pacoesteban/CC_Dummy_Load/panell_frontal.dxf

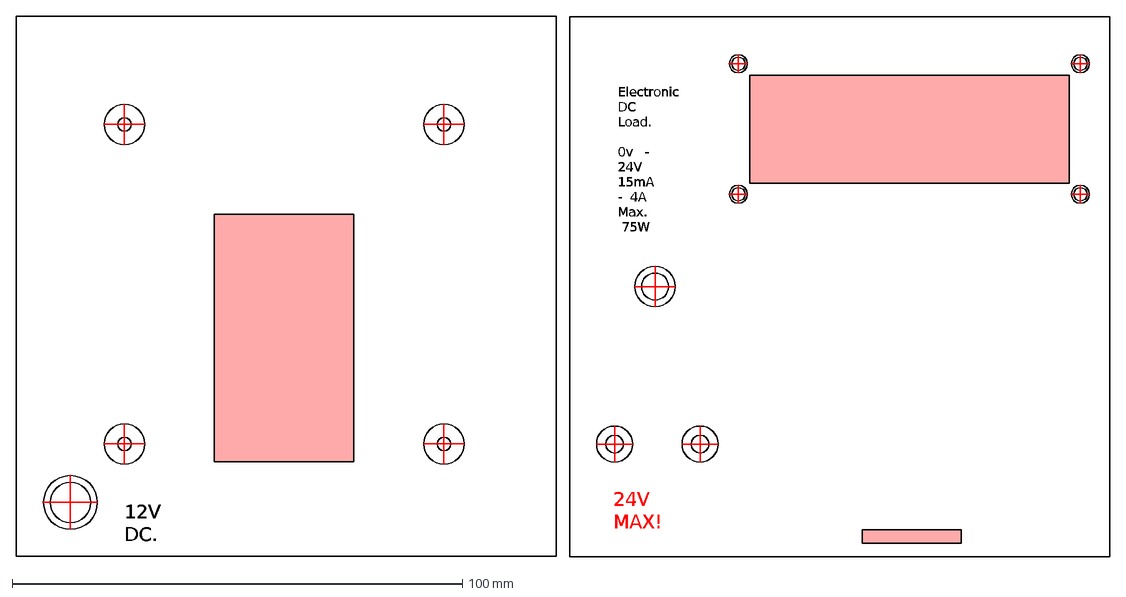
[picture p1: CAD file, 2016-04-08]
panell_frontal.dxf
12V DC.
Electronic DC Load. 0v - 24V 15mA - 4A Max. 75W
24V MAX!
