pacoesteban/CC_Dummy_Load/CC_dummy_load.kicad_pcb

## KiCad design CC_dummy_load.kicad_pcb (2016-03-09)

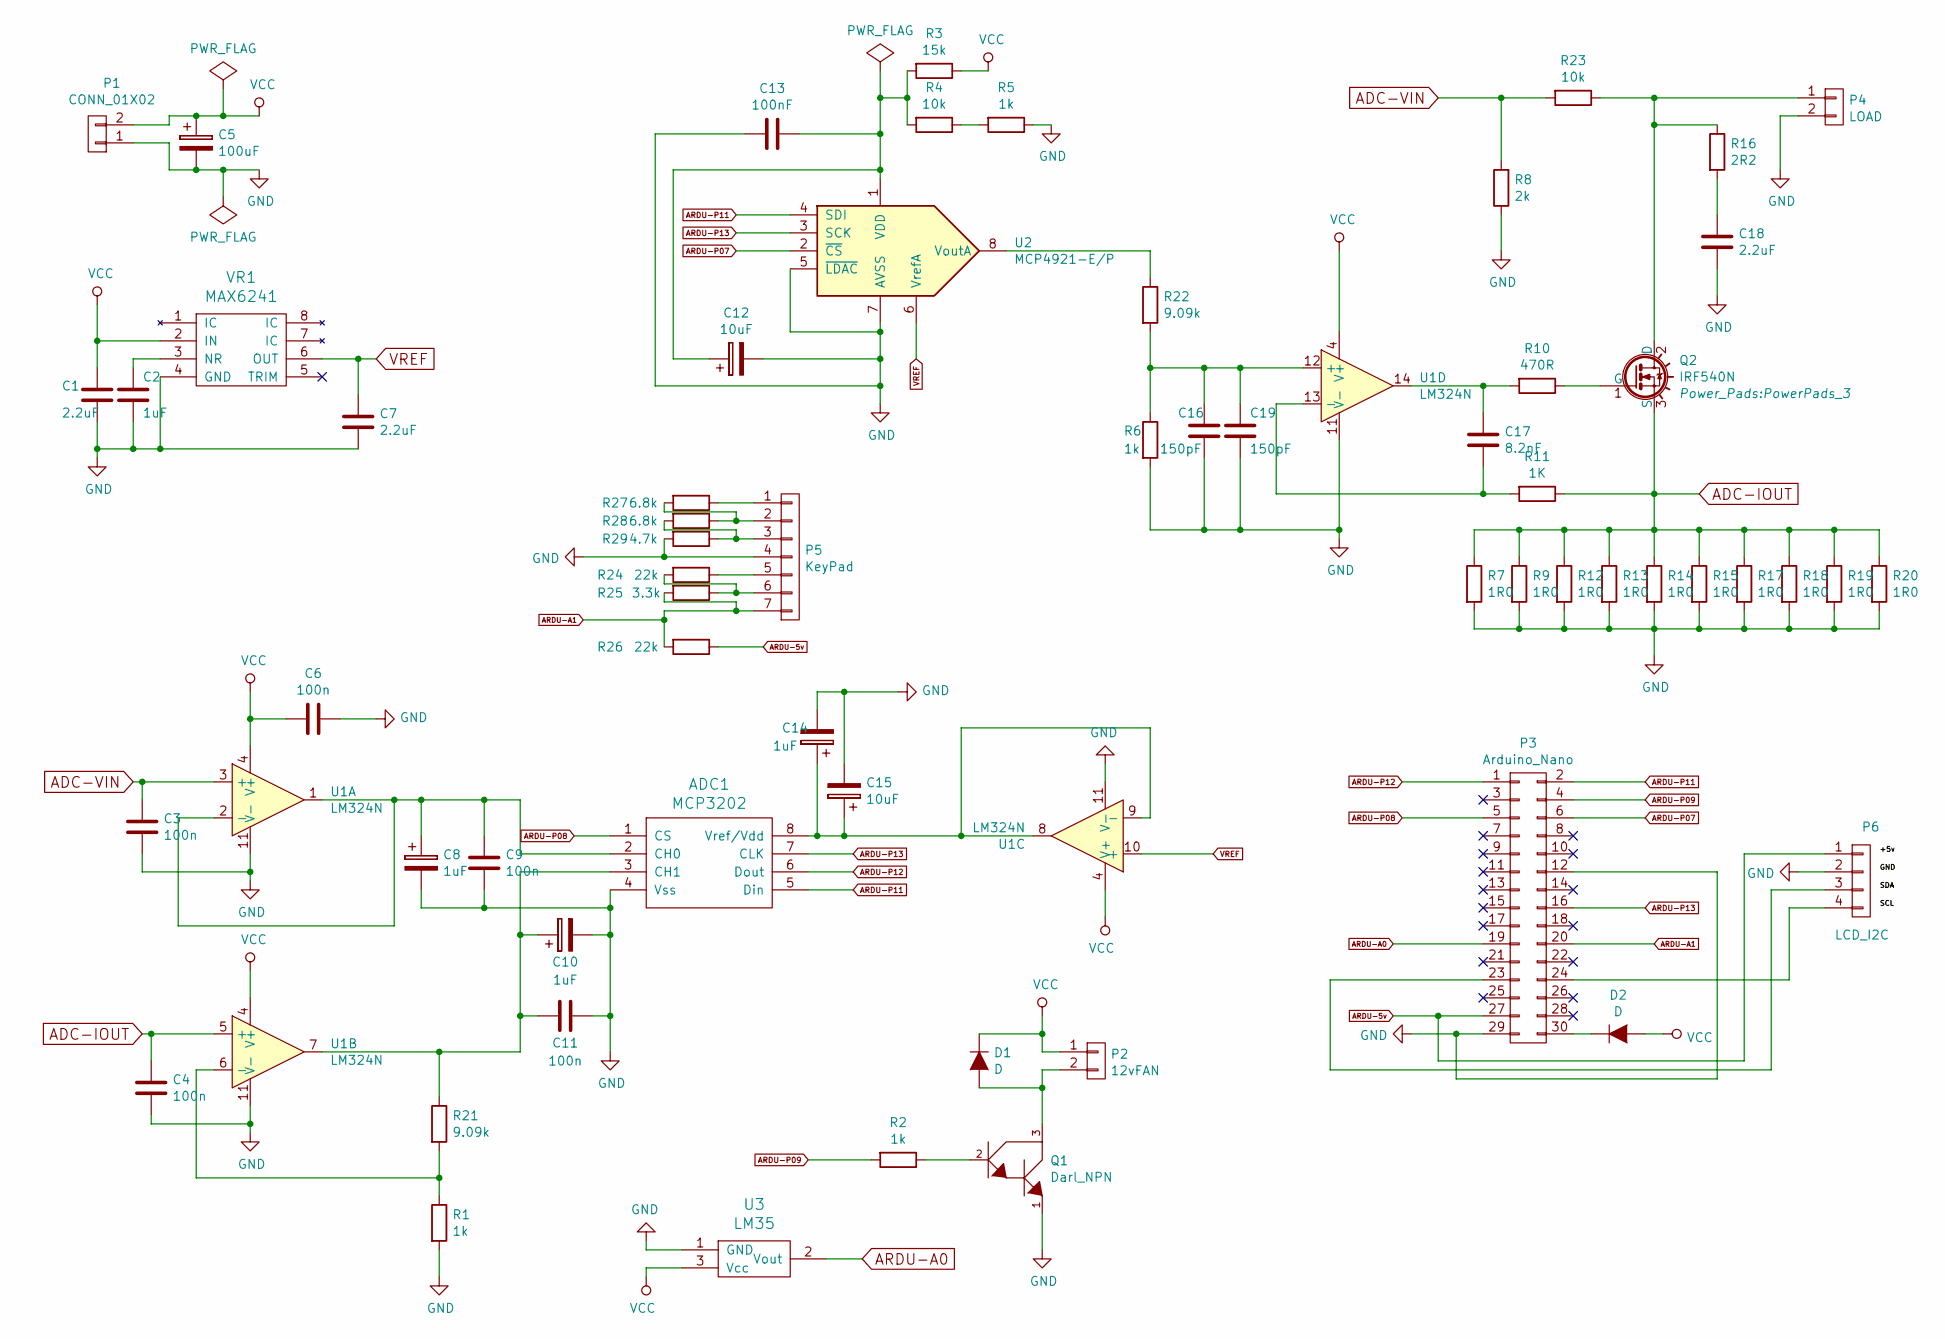
[picture p2: schematic CC_dummy_load.sch, Fucking DC Dummy Load]

Parts:
ADC1: MCP3202; DIP-8_W7.62mm
C1, C7, C18: 2.2uF; C_Disc_D6_P5
C2, C8, C10, C14: 1uF; C_Radial_D5_L11_P2
C3, C4, C6: 100n; C_Disc_D3_P2.5
C5: 100uF; C_Radial_D5_L11_P2.5
C9, C11: 100n; C_Disc_D6_P5
C12, C15: 10uF; C_Radial_D5_L11_P2
C13: 100nF; C_Disc_D6_P5
C16, C19: 150pF; C_Disc_D3_P2.5
C17: 8.2nF; C_Radial_D5_L11_P2
D1, D2: D; Diode_DO-41_SOD81_Horizontal_RM10
P1: CONN_01X02; bornier2
P2: 12vFAN; Pin_Header_Straight_1x02
P3: Arduino_Nano; Nano
P4: LOAD; bornier2
P5: KeyPad; Pin_Header_Straight_1x07
P6: LCD_I2C; Pin_Header_Straight_1x04
Q1: Darl_NPN; TO-92_Inline_Wide
Q2: IRF540N; PowerPads_3
R1, R2, R5, R6: 1k; Resistor_Horizontal_RM10mm
R3: 15k; Resistor_Horizontal_RM10mm
R4, R23: 10k; Resistor_Horizontal_RM10mm
R7, R9, R12, R13, R14, R15, R17, R18, R19, R20: 1R0; Resistor_Horizontal_RM10mm
R8: 2k; Resistor_Horizontal_RM10mm
R10: 470R; Resistor_Horizontal_RM10mm
R11: 1K; Resistor_Horizontal_RM10mm
R16: 2R2; Resistor_Horizontal_RM10mm
R21, R22: 9.09k; Resistor_Horizontal_RM10mm
R24, R26: 22k; Resistor_Horizontal_RM10mm
R25: 3.3k; Resistor_Horizontal_RM10mm
R27, R28: 6.8k; Resistor_Horizontal_RM10mm
R29: 4.7k; Resistor_Horizontal_RM10mm
U1: LM324N; DIP-14_W7.62mm
U2: MCP4921-E/P; DIP-8_W7.62mm
U3: LM35; Pin_Header_Straight_1x03
VR1: MAX6241; DIP-8_W7.62mm

Connections:
ADC-IOUT: C4.1, Q2.3 (S), R7.1, R9.1, R11.1, R12.1, R13.1, R14.1, R15.1, R17.1, R18.1, R19.1, R20.1, U1.5 (+)
ADC-VIN: C3.1, R8.2, R23.2, U1.3 (+)
ARDU-5v: P3.27, P6.1, R26.1
ARDU-A0: P3.19, U3.2 (Vout)
ARDU-A1: P3.20, P5.7, R25.2, R26.2
ARDU-P07: P3.6, U2.2 (~CS~)
ARDU-P08: ADC1.1 (CS), P3.5
ARDU-P09: P3.4, R2.2
ARDU-P11: ADC1.5 (Din), P3.2, U2.4 (SDI)
ARDU-P12: ADC1.6 (Dout), P3.1
ARDU-P13: ADC1.7 (CLK), P3.16, U2.3 (SCK)
GND: ADC1.4 (Vss), C1.2, C2.2, C3.2, C4.2, C5.2, C6.1, C7.2, C8.2, C9.2, C10.2, C11.1, C12.2, C13.2, C14.2, C15.2, C16.2, C18.2, C19.2, P1.1, P3.12, P3.29, P4.2, P5.4, P6.2, Q1.1, R1.2, R5.1, R6.2, R7.2, R8.1, R9.2, R12.2, R13.2, R14.2, R15.2, R17.2, R18.2, R19.2, R20.2, R29.2, U1.11 (V-), U2.5 (~LDAC~), U2.7 (AVSS), U3.1 (GND), VR1.4 (GND)
unnamed: ADC1.2 (CH0), C8.1, C9.1, U1.1, U1.2 (-)
unnamed: ADC1.3 (CH1), C10.1, C11.2, R21.1, U1.7
unnamed: ADC1.8 (Vref/Vdd), C14.1, C15.1, U1.8, U1.9 (-)
unnamed: C2.1, VR1.3 (NR)
unnamed: C12.1, C13.1, R3.2, R4.2, U2.1 (VDD)
unnamed: C16.1, C19.1, R6.1, R22.2, U1.12 (+)
unnamed: C17.1, R10.2, U1.14
unnamed: C17.2, R11.2, U1.13 (-)
unnamed: C18.1, R16.2
unnamed: D1.2 (A), P2.2, Q1.3
unnamed: D2.1 (K), P3.30
unnamed: P3.23, P6.3
unnamed: P3.24, P6.4
unnamed: P4.1, Q2.2 (D), R16.1, R23.1
unnamed: P5.1, R27.1
unnamed: P5.2, R27.2, R28.1
unnamed: P5.3, R28.2, R29.1
unnamed: P5.5, R24.1
unnamed: P5.6, R24.2, R25.1
unnamed: Q1.2, R2.1
unnamed: Q2.1 (G), R10.1
unnamed: R1.1, R21.2, U1.6 (-)
unnamed: R4.1, R5.2
unnamed: R22.1, U2.8 (VoutA)
VCC: C1.1, C5.1, C6.2, D1.1 (K), D2.2 (A), P1.2, P2.1, R3.1, U1.4 (V+), U3.3 (Vcc), VR1.2 (IN)
VREF: C7.1, U1.10 (+), U2.6 (VrefA), VR1.6 (OUT)

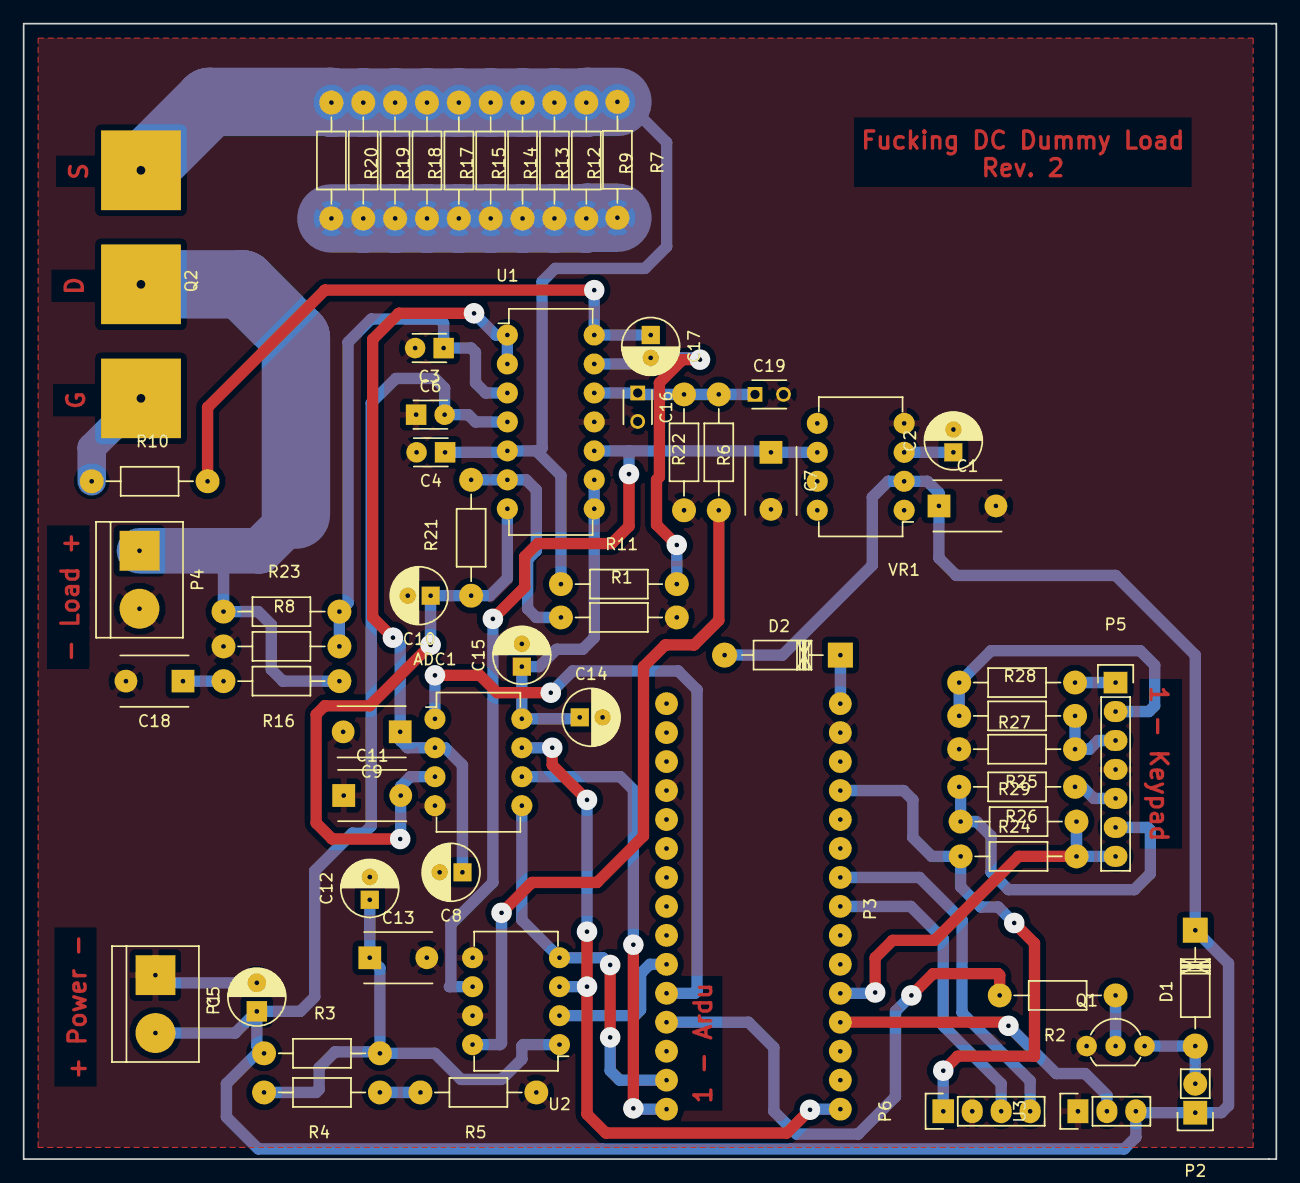
[picture p3: board CC_dummy_load.kicad_pcb from above]

Board: 2 copper layers, 109.9 x 99.6 mm, 63 parts (0 on the bottom side), 38 nets.
