pacoesteban/CC_Dummy_Load/src/main.ino

#include <SPI.h>
#include <Wire.h>
#include <LiquidCrystal_I2C.h>

#define DAC_CS 7
#define ADC_CS 8
#define KEYPAD_PIN A1
#define FAN_PIN 9
#define INTERVAL 1000
#define K_INTERVAL 250
#define CURRENT_LIMIT 4095
#define POWER_LIMIT 75000
#define MAX_POWER 75

// Matrix setup
const int SmallestGap = 40;
const int nButtons = 12;
int AnalogVals[] = {1023, 680, 640, 590, 547, 507, 464,
                    411, 351, 273, 180, 133, 0};
int Buttons[] =    {0,    '1', '4', '7', '*', '2', '3',
                    '5', '6', '8', '9', '0', '#'};

unsigned long currentMillis = 0;
unsigned long previousMillis = 0;
unsigned long k_currentMillis = 0;
unsigned long k_previousMillis = 0;
unsigned long bat_start_time = 0;
unsigned long currentTimeSec = 0;
int incLoad = 0;
int current = 0;
long power = 0;
long resistance = 0;
char menu = '1';
bool draw = true;
bool load = false;
char keyPressed = 'z';
float ampsIn = 0;
float voltsIn = 0;
float ampsError = 0;
float powerIn = 0;
float v_cut = 2.8;
int mAh = 0;

LiquidCrystal_I2C lcd(0x27, 2, 1, 0, 4, 5, 6, 7, 3, POSITIVE);

/* Menu and print functions */
void printWelcome()
{
    lcd.setCursor(0,0);
    lcd.print("CC Dummy Load");
    lcd.setCursor(0,1);
    lcd.print(".....");
}

void drawMenu(int menu_section, bool setMenu = false)
{
    if (draw) {
        lcd.clear();
        String sectionTitle;
        char line2[17];
        float valueFloat;
        char valueStr[8];
        switch (menu_section) {
            case '1':
                if (setMenu) {
                    sectionTitle = "Set Current";
                    sprintf(line2, "        A");
                } else {
                    sectionTitle = "Constant Current";
                    valueFloat = (float)current / 1000.0;
                    dtostrf(valueFloat,3,3,valueStr);
                    sprintf(line2, "%s  A", valueStr);
                }
                break;
            case '2':
                if (setMenu) {
                    sectionTitle = "Set Power";
                    sprintf(line2, "        W");
                } else {
                    sectionTitle = "Constant Power";
                    valueFloat = (float)power / 1000.0;
                    dtostrf(valueFloat,3,3,valueStr);
                    sprintf(line2, "%s  W", valueStr);
                }
                break;
            case '3':
                if (setMenu) {
                    sectionTitle = "Set disch. curr.";
                    sprintf(line2, "       A");
                } else {
                    sectionTitle = "Battery Disch.";
                    valueFloat = (float)current / 1000.0;
                    dtostrf(valueFloat,3,3,valueStr);
                    sprintf(line2, "%s  A", valueStr);
                }
                break;
            default:
                sectionTitle = "Option not";
                sprintf(line2, "available");
        }
        lcd.setCursor(0,0);
        lcd.print(sectionTitle);
        lcd.setCursor(5,1);
        lcd.print(line2);
    }
}

void setValueMenu(char menu_section)
{
    float userInput;

    lcd.clear();
    lcd.cursor();
    lcd.blink();
    draw = true;
    drawMenu(menu, true);
    lcd.setCursor(5,1);
    userInput = getValue(5);
    switch (menu_section) {
        case '1':
            current = round(userInput * 1000.0);
            break;
        case '2':
            power = round(userInput * 1000.0);
            break;
        case '3':
            current = round(userInput * 1000.0);
            break;
        default:
            lcd.setCursor(0,0);
            lcd.print("No mode !");
            menu = 1;
    }
    lcd.noCursor();
    lcd.noBlink();
    drawMenu(menu);
}

void printResult()
{
    lcd.clear();
    lcd.setCursor(0,0);
    lcd.print("Battery Disch.");
    lcd.setCursor(0,1);
    lcd.print(mAh);
    lcd.print(" mAh");
}

void drawOnLoad()
{

    char line1[16];
    char line2[16];

    lcd.clear();
    lcd.setCursor(0,0);

    switch (menu) {
        case '1':
            sprintf(line1, "CC %4dmA %4ldmA", current, round((ampsIn * 1000.000) + ampsError));
            lcd.print(line1);
            /* lcd.print(ampsIn); */
            lcd.setCursor(0,1);
            lcd.print("ON ");
            if (voltsIn < 1) {
                lcd.print(round(voltsIn*1000));
                lcd.print("mV ");
            } else {
                lcd.print(voltsIn, 2);
                lcd.print("V ");
            }
            if (powerIn < 1) {
                lcd.print(round(powerIn*1000));
                lcd.print("mW");
            } else {
                lcd.print(powerIn, 2);
                lcd.print("W");
            }
            break;
        case '2':
            lcd.print("CP ");
            if (power < 1000) {
                lcd.print(power);
                lcd.print("mW ");
            } else {
                lcd.print(power/1000.000, 2);
                lcd.print("W ");
            }
            if (powerIn < 1) {
                lcd.print(round(powerIn*1000));
                lcd.print("mW");
            } else {
                lcd.print(powerIn, 2);
                lcd.print("W");
            }
            lcd.setCursor(0,1);
            lcd.print("ON ");
            if (voltsIn < 1) {
                lcd.print(round(voltsIn*1000));
                lcd.print("mV ");
            } else {
                lcd.print(voltsIn, 2);
                lcd.print("V ");
            }
            sprintf(line2, "%4ldmA", round(ampsIn * 1000.000));
            lcd.print(line2);
            break;
        case '3':
            currentTimeSec = (currentMillis - bat_start_time)/1000;
            sprintf(line1, "BD %4dmA ", current);
            lcd.print(line1);
            printTimeOn(currentTimeSec);
            lcd.setCursor(0,1);
            lcd.print("ON ");
            if (voltsIn < 1) {
                lcd.print(round(voltsIn*1000));
                lcd.print("mV ");
            } else {
                lcd.print(voltsIn, 2);
                lcd.print("V ");
            }
            mAh = round(current*((float)currentTimeSec/3600));
            lcd.print(mAh);
            lcd.print("mAh");
            break;
        default:
            lcd.print("foo");
    }
    
}

void printTimeOn(long currentSec)
{
    int seconds;
    int minutes;

    minutes = currentSec / 60;
    seconds = currentSec % 60;
    if (minutes < 10) {
        lcd.print("0");
    }
    lcd.print(minutes);
    lcd.print(":");
    if (seconds < 10) {
        lcd.print("0");
    }
    lcd.print(seconds);
}


void drawError(const char line1[17], const char line2[17])
{
    lcd.clear();
    lcd.setCursor(0,0);
    lcd.print(line1);
    lcd.setCursor(0,1);
    lcd.print(line2);
    draw = true;
    delay(1500);
}

void serialOut()
{
    Serial.print(menu); Serial.print(",");
    Serial.print(current); Serial.print(",");
    Serial.print(voltsIn*1000); Serial.print(",");
    Serial.print((ampsIn*1000) + ampsError); Serial.print(",");
    Serial.print(powerIn); Serial.print(",");
    Serial.print(v_cut); Serial.print(",");
    Serial.print(mAh); Serial.print(",");
    Serial.println(currentTimeSec);
}

/* //// Menu and print functions */

/* Action functions */
void startCC()
{
    if (current > CURRENT_LIMIT) {
        current = CURRENT_LIMIT;
    }
    if (current > 0) {
        updateCurrent();
    }

}

void startCP()
{
    if (power > POWER_LIMIT) {
        power = POWER_LIMIT;
    }
    if (power > 0) {
        updateCurrent();
    }
}
void startBD()
{
    bat_start_time = millis();
    startCC();
}

void updateCurrent()
{
    int target_mA;
    switch (menu) {
        case '1':
            target_mA = current;
            break;
        case '2':
            target_mA = round((float)power / voltsIn);
            break;
        case '3':
            target_mA = current;
            break;
        default:
            setDac(0);
    }
    if (target_mA > CURRENT_LIMIT) {
        target_mA = CURRENT_LIMIT;
    }
    if (target_mA > 0) {
        setDac(target_mA);
    }
}

float getValue(int pos)
{
    String inString;
    char newchar;
    newchar = readKeypad();
    while (newchar != '#') {
        if (isDigit(newchar)) {
            lcd.setCursor(pos,1);
            lcd.print(newchar);

            inString += (char)newchar;
            pos++;
        }
        if (newchar == '*') {
            lcd.setCursor(pos,1);
            lcd.print('.');

            inString += '.';
            pos++;
        }
        newchar = readKeypad();
    }
    return inString.toFloat();
}

void setFanSpeed(int watts)
{
    int fanValue;
    fanValue = map(watts, 1, 45, 110, 255);
    if (watts < 1) {
        fanValue = 0;
    }
    if (watts > 45) {
        fanValue = 255;
    }
    analogWrite(FAN_PIN, fanValue);
}
/* //// Action functions */

/* Read Value functions */
char readKeypad()
{
    k_currentMillis = millis();
    if ((k_currentMillis - k_previousMillis) > K_INTERVAL) {
        k_previousMillis = k_currentMillis;
        int sensorValue = analogRead(KEYPAD_PIN) + SmallestGap/2;
        for (int i=0; i<=nButtons; i++) {
            if (sensorValue >= AnalogVals[i]) return Buttons[i];
        }
    }
    return 'x';
}
/* //// Read Value functions */

/* Low level functions */
float readAdc(int channel)
{
  byte adcPrimaryConfig = 0b00000001;     // only contains the start bit
  byte adcSecondaryConfig;
  if (channel == 0) {
      adcSecondaryConfig = 0b10100000;
  } else {
      adcSecondaryConfig = 0b11100000;
  }
  noInterrupts(); // disable interupts to prepare to send address data to the ADC.  
  digitalWrite(ADC_CS,LOW); // take the Chip Select pin low to select the ADC.
  SPI.transfer(adcPrimaryConfig); //  send in the primary configuration address byte to the ADC.  
  byte adcPrimaryByte = SPI.transfer(adcSecondaryConfig); // read the primary byte, also sending in the secondary address byte.  
  byte adcSecondaryByte = SPI.transfer(0x00); // read the secondary byte, also sending 0 as this doesn't matter. 
  digitalWrite(ADC_CS,HIGH); // take the Chip Select pin high to de-select the ADC.
  interrupts(); // Enable interupts.
  byte adcPrimaryByteMask = 0b00001111;      // b00001111 isolates the 4 LSB for the value returned. 
  adcPrimaryByte &= adcPrimaryByteMask; // Limits the value of the primary byte to the 4 LSB:
  int digitalValue = (adcPrimaryByte << 8) | adcSecondaryByte; // Shifts the 4 LSB of the primary byte to become the 4 MSB of the 12 bit digital value, this is then ORed to the secondary byte value that holds the 8 LSB of the digital value.
  float value = ((float)digitalValue * 4.096) / 4095.000; // The digital value is converted to an analogue voltage using a VREF of 4096V.

  return value; // Returns the value from the function
}

void setDac(int value)
{
    /*
       Sets default DAC registers B00110000, 1st bit "write to register",
       2nd Bit bypasses input Buffer, 3rd bit sets output gain to 1x, 4th
       bit controls active low shutdown. LSB are insignifigant here.
    */
    byte dacRegister = 0b00110000;
    // Isolates the last 8 bits of the 12 bit value, B0000000011111111.
    int dacSecondaryByteMask = 0b0000000011111111;
    /*
       Value is a maximum 12 Bit value, it is shifted to the right by 8
       bytes to get the first 4 MSB out of the value for entry into th
       Primary Byte, then ORed with the dacRegister  
    */
    byte dacPrimaryByte = (value >> 8) | dacRegister;
    // compares the 12 bit value to isolate the 8 LSB and reduce it to a single byte. 
    byte dacSecondaryByte = value & dacSecondaryByteMask;

    noInterrupts(); // disable interupts to prepare to send data to the DAC
    digitalWrite(DAC_CS,LOW); // take the Chip Select pin low to select the DAC:
    SPI.transfer(dacPrimaryByte); //  send in the Primary Byte:
    SPI.transfer(dacSecondaryByte);// send in the Secondary Byte
    digitalWrite(DAC_CS,HIGH);// take the Chip Select pin high to de-select the DAC:
    interrupts(); // Enable interupts
}
/* //// Low level functions */

void setup()
{
    pinMode(DAC_CS, OUTPUT);
    digitalWrite(DAC_CS, HIGH);
    pinMode(ADC_CS, OUTPUT);
    digitalWrite(ADC_CS, HIGH);
    // Timer1 now runs at 31372.55Hz
    // this way we don't "hear" the PWM to the fan.
    TCCR1B = (TCCR1B & 0b11111000) | 0x01; 
    SPI.begin();
    SPI.setBitOrder(MSBFIRST);
    SPI.setDataMode(SPI_MODE0);
    /* SPI.setClockDivider(SPI_CLOCK_DIV16); */
    SPI.setClockDivider(SPI_CLOCK_DIV8);
    setDac(0);
    setFanSpeed(0);

    Serial.begin(9600);

    lcd.begin(16,2);
    lcd.backlight();
    lcd.clear();
    delay(500);
    printWelcome();
    delay(500);
    drawMenu(menu);
}

void loop()
{
    if (load) {
        currentMillis = millis();
        if ((currentMillis - previousMillis) > INTERVAL) {
            previousMillis = currentMillis;
            ampsIn = readAdc(1);
            if (current < 1500) {
                ampsError = 11.0;
            } else if (current < 2400) {
                ampsError = 13.0;
            } else if (current < 3000) {
                ampsError = 14.0;
            } else if (current < 3800) {
                ampsError = 12.0;
            }
            voltsIn = (readAdc(0) * 6.09);
            powerIn = ampsIn * voltsIn;

            if (powerIn < MAX_POWER) {
                setFanSpeed(powerIn);
            } else {
                load = false;
                setDac(0);
                setFanSpeed(100);
                drawError("Power", "Overload !!!");
                delay(5000);
                setFanSpeed(0);
            }

            drawOnLoad();
            updateCurrent();
            serialOut();
            if (menu == '3') {
                if (voltsIn < v_cut) {
                    load = false;
                    setDac(0);
                    setFanSpeed(0);
                    printResult();
                }
            }
        }
    } else {
        setFanSpeed(0);
    }
    keyPressed = readKeypad();
    if (keyPressed == '#') {
        if (load) {
            /* drawError("No, man.", "Not that way"); */
        } else {
            setValueMenu(menu);
        }
    }
    if (keyPressed == '*') {
        load = !load;
        if (load) {
            /* Start ! */
            if (menu == '1') {
                startCC();
            }
            if (menu == '2') {
                startCP();
            }
            if (menu == '3') {
                startBD();
            }
        } else {
            /* Stop ! */
            setDac(0);
            draw = true;
            drawMenu(menu);
        }
    }
    if (isDigit(keyPressed)) {
        if (load) {
            switch (keyPressed) {
                case '2':
                    incLoad = 100;
                    break;
                case '8':
                    incLoad = -100;
                    break;
                case '6':
                    incLoad = 10;
                    break;
                case '4':
                    incLoad = -10;
                    break;
                default:
                    incLoad = 0;
            }

            switch (menu) {
                case '1':
                    if ((current > 0) && (current < CURRENT_LIMIT)) {
                        current += incLoad;
                    }
                    break;
                case '2':
                    if ((power > 0) && (power < POWER_LIMIT)) {
                        power += incLoad;
                    }
                    break;
                default:
                    incLoad = 0;
            }
        } else {
            menu = keyPressed;
            draw = true;
            drawMenu(menu);
        }
    }
    draw = false;
}
