pacoesteban/CC_Dummy_Load/(commit log)

2016-02-05 adc code
2016-02-06 trying to fix ADC missreadings
    [CC_dummy_load.ino]
2016-02-07 fixing amps reading on software because I suck at basic electrocnics
    [CC_dummy_load.ino]
2016-02-19 final design v1
    [CC_dummy_load.sch]
2016-02-19 change thermistor for LM35
    [CC_dummy_load.sch]
2016-02-22 temperature limit cutoff
2016-02-24 associated components and starting to layout PCB
    [CC_dummy_load.sch]
2016-02-25 PCB first version
    [_saved_CC_dummy_load.sch]
2016-02-26 redesign with much more vias to be able to make it DIY
    [CC_dummy_load.kicad_pcb]
2016-02-26 more coper on back face
    [CC_dummy_load.kicad_pcb]
2016-03-09 rev 2
    [CC_dummy_load.kicad_pcb, CC_dummy_load.sch]
2016-03-17 mounting holes and stuff
    [CC_dummy_load.kicad_pcb]
2016-03-17 we can see temperature now while on load
2016-03-19 Revert "mounting holes and stuff"
    This reverts commit a6e826f9ddd28fcc19281836c77182ce96cc9986.
    [CC_dummy_load.kicad_pcb]
2016-03-19 ajustos previs al montatge i cagada temperatura
2016-04-08 Ardu no llegeix la etmp, passem a control de fan per Watts
2016-04-08 panell frontal
    [panell_frontal.dxf]
2016-04-08 mods panell frontal
    [panell_frontal.dxf]
2016-04-14 constant resistance
2016-06-19 basic battery discharge
2017-01-17 preparing for platformio
    [div10_full.csv, new.csv]
